FilipPieniazek/Design-of-an-unmanned-aerial-vehicle-with-a-proprietary-flight-controller/oprogramowanie/biblioteki/Grove_IMU_9DOF-master/README.md

Grove IMU 9DOF   
---------------------------------------------------------
Grove IMU 9DOF (http://www.seeedstudio.com/depot/Grove-IMU-9DOF-p-1728.html?cPath=25_134)

Grove - IMU 9DOF is a high performance 9-axis motion tracking module,which is base on MPU-9150.The MPU-9150 is the world's first integrated 9-axis motion tracking device designed for the low power, low cost, and high performance requirements of consumer electronics equipment including smartphones, tablets and wearable sensors .MPU-9150 features three 16-bit ADC for digitizing the gyroscope outputs and three 16-bit ADCs for digitizing the accelerometer outputs and three 13-bit ADCs for digitizing the magnetometer outputs.

Specifications:

- I2C interface 
- Low cost 
- 400kHz Fast Mode I2C for communicating with all registers 
- Digital-output X-, Y-, and Z-Axis angular rate sensors (gyroscopes) with a user-programmable full-scale range of ±250, ±500, ±1000, and ±2000°/sec
- Digital-output 3-Axis accelerometer with a programmable full scale range of ±2g, ±4g, ±8g and ±16g
- 3-axis silicon monolithic Hall-effect magnetic sensor with magnetic concentrator

### Usage:

This code include some examples which can show you how to use the Grove IMU 9DOF . 

For more information, please refer to [wiki page](http://wiki.seeed.cc/Grove-IMU_9DOF_v2.0/).

----

This software is written by loovee [luweicong@seeedstudio.com](luweicong@seeedstudio.com "luweicong@seeedstudio.com") for seeed studio<br>
and is licensed under [The MIT License](http://opensource.org/licenses/mit-license.php). Check License.txt for more information.<br>

Contributing to this software is warmly welcomed. You can do this basically by<br>
[forking](https://help.github.com/articles/fork-a-repo), committing modifications and then [pulling requests](https://help.github.com/articles/using-pull-requests) (follow the links above<br>
for operating guide). Adding change log and your contact into file header is encouraged.<br>
Thanks for your contribution.

Seeed Studio is an open hardware facilitation company based in Shenzhen, China. <br>
Benefiting from local manufacture power and convenient global logistic system, <br>
we integrate resources to serve new era of innovation. Seeed also works with <br>
global distributors and partners to push open hardware movement.<br>

Analytics (https://github.com/igrigorik/ga-beacon)
