FilipPieniazek/Design-of-an-unmanned-aerial-vehicle-with-a-proprietary-flight-controller/oprogramowanie/biblioteki/SparkFun_Ublox_Arduino_Library-master/img/Contributing.JPG

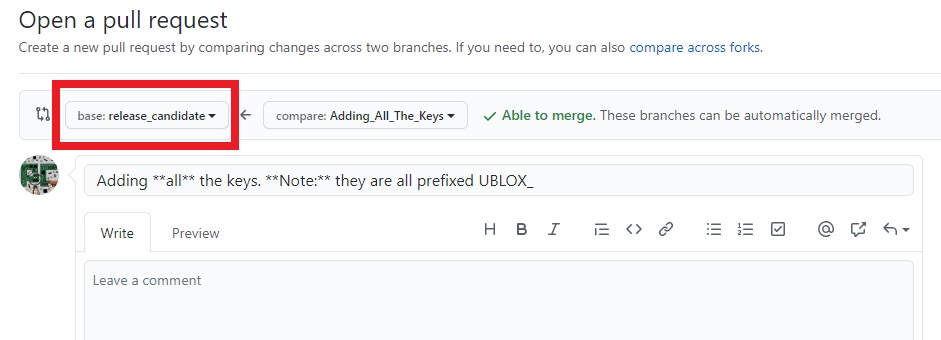
oprogramowanie/biblioteki/SparkFun_Ublox_Arduino_Library-master/img/Contributing.JPG
