FilipPieniazek/Design-of-an-unmanned-aerial-vehicle-with-a-proprietary-flight-controller/oprogramowanie/kontroler/PWM.hpp

#include <Arduino.h>

class PWM {
    byte my_isr;
    
public:
    PWM(byte pin);
    
    /**
     Enables interrupt.
     @param measure_pulse_high true: High Pulse duration is measured (normal pwm), false: Low Pulse duration is measured (inverted pwm).
     
     @return 0 Success.
     @return -1 Error.
     */
    int begin(bool measure_pulse_high);
    
    /**
     Returns the most recent PWM value received.
     @return PWM duration in microseconds.
     */
    unsigned int getValue();
    
    /**
     Returns the age of recent PWM value.
     @return Age in microseconds.
     */
    unsigned long getAge();
    
    /**
     Disables interrupt.
     */
    void end();
};
