FilipPieniazek/Design-of-an-unmanned-aerial-vehicle-with-a-proprietary-flight-controller/oprogramowanie/biblioteki/SparkFun_Ublox_Arduino_Library-master/examples/ZED-F9P/Example14_NTRIPServer/secrets.h

//Your WiFi credentials
const char* ssid = "TRex";
const char* password =  "hasBigTeeth";

//Your RTK2GO mount point credentials
const char* mntpnt_pw = "WR5wRo4H";
const char* mntpnt = "bldr_dwntwn2";
