FilipPieniazek/Design-of-an-unmanned-aerial-vehicle-with-a-proprietary-flight-controller/(commit log)

2022-10-29 poczatek implementacji PID
2022-11-17 dzialajacy PID, niewyregulowany
